wwaltz2/ECE445-UIUC-Heterodyne/README.md

# ECE445-UIUC-Heterodyne
For ease of sharing files, journals, code, and schematics while we design, revise, build, and report on our senior design project.
