wwaltz2/ECE445-UIUC-Heterodyne/Firmware/WAV Files/From Dr OK/For Bill/Big brown bat (Eptesicus fuscus).png

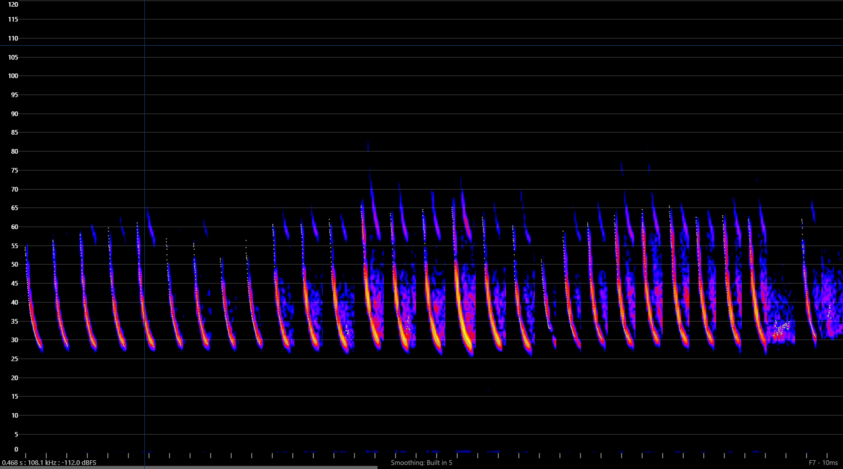
Firmware/WAV Files/From Dr OK/For Bill/Big brown bat (Eptesicus fuscus).png
