wwaltz2/ECE445-UIUC-Heterodyne/Firmware/WAV Files/From Dr OK/For Bill/Eastern red bat (Lasiurus borealis).png

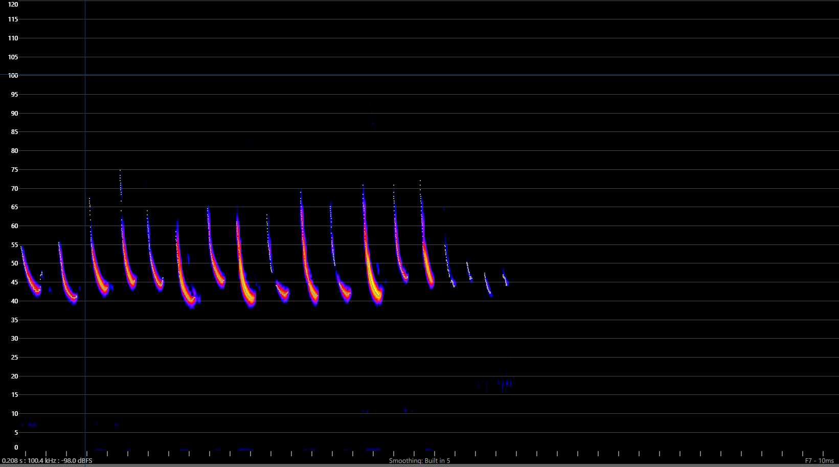
Firmware/WAV Files/From Dr OK/For Bill/Eastern red bat (Lasiurus borealis).png
