wwaltz2/ECE445-UIUC-Heterodyne/Firmware/WAV Files/From Dr OK/For Bill/Indiana bat (Myotis sodalis).png

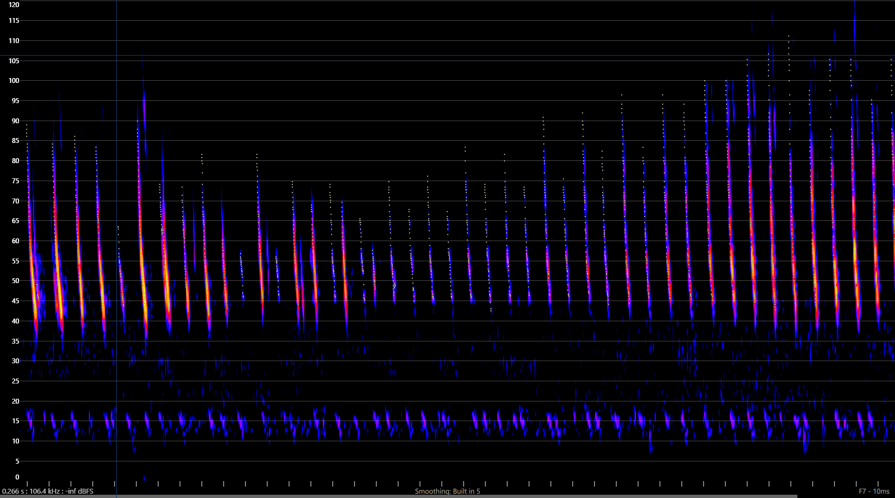
Firmware/WAV Files/From Dr OK/For Bill/Indiana bat (Myotis sodalis).png
