wwaltz2/ECE445-UIUC-Heterodyne/Journals/kaj5/5-6-26_final_chassis.png

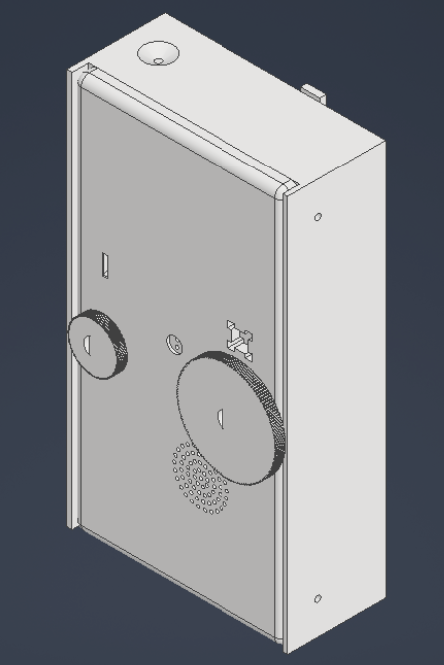
Journals/kaj5/5-6-26_final_chassis.png
