wwaltz2/ECE445-UIUC-Heterodyne/3D Printer Files/Assembly.3mf

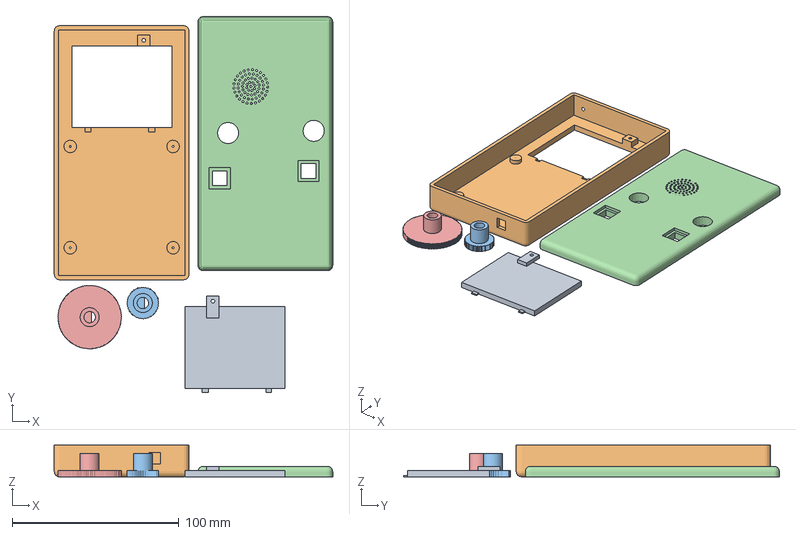
[picture p5: CAD file, 2026-04-19]
3D Printer Files/Assembly.3mf
167.0 x 225.4 x 19.0 mm
batteryFlap.stl
Bottom_Shell.stl
Dial.stl
Top_Shell.stl
freqDial1.stl
