wwaltz2/ECE445-UIUC-Heterodyne/Chassis/3D_print_format/STEP/Top_Shell.stp

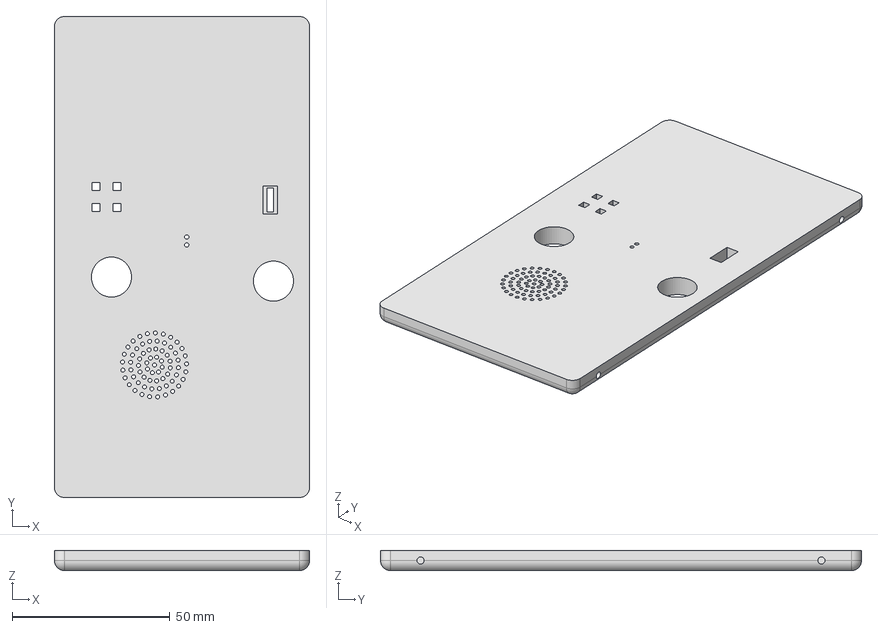
[picture p6: CAD file, 2026-04-22]
Chassis/3D_print_format/STEP/Top_Shell.stp
80.8 x 152.4 x 6.35 mm
