wwaltz2/ECE445-UIUC-Heterodyne/3D Printer Files/batteryFlap.stl

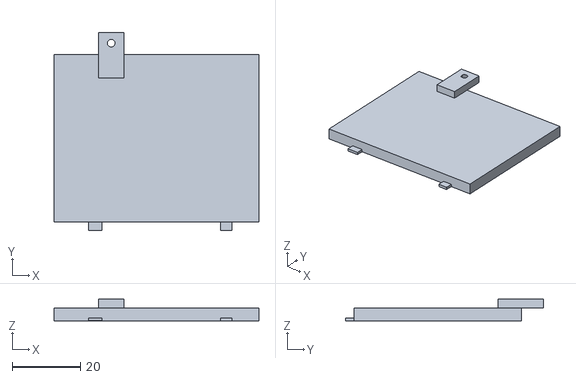
[picture p7: CAD file, 2026-04-19]
3D Printer Files/batteryFlap.stl
59.9 x 58.0 x 6.35
