wwaltz2/ECE445-UIUC-Heterodyne/Chassis/3D_print_format/STEP/Bottom_Shell.stp

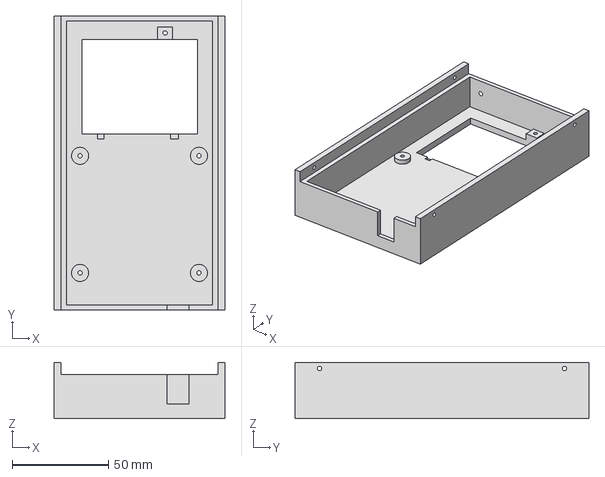
[picture p8: CAD file, 2026-04-20]
Chassis/3D_print_format/STEP/Bottom_Shell.stp
88.5 x 152.4 x 29.2 mm
