wwaltz2/ECE445-UIUC-Heterodyne/Chassis/3D_print_format/team3.3mf

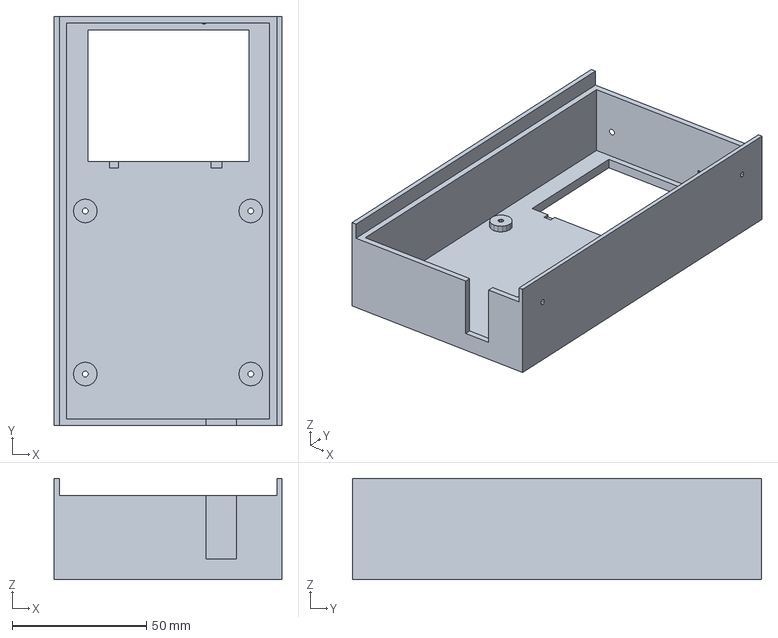
[picture p9: CAD file, 2026-04-27]
Chassis/3D_print_format/team3.3mf
84.9 x 152.4 x 37.7 mm
