wwaltz2/ECE445-UIUC-Heterodyne/3D Printer Files/Top_Shell.stl

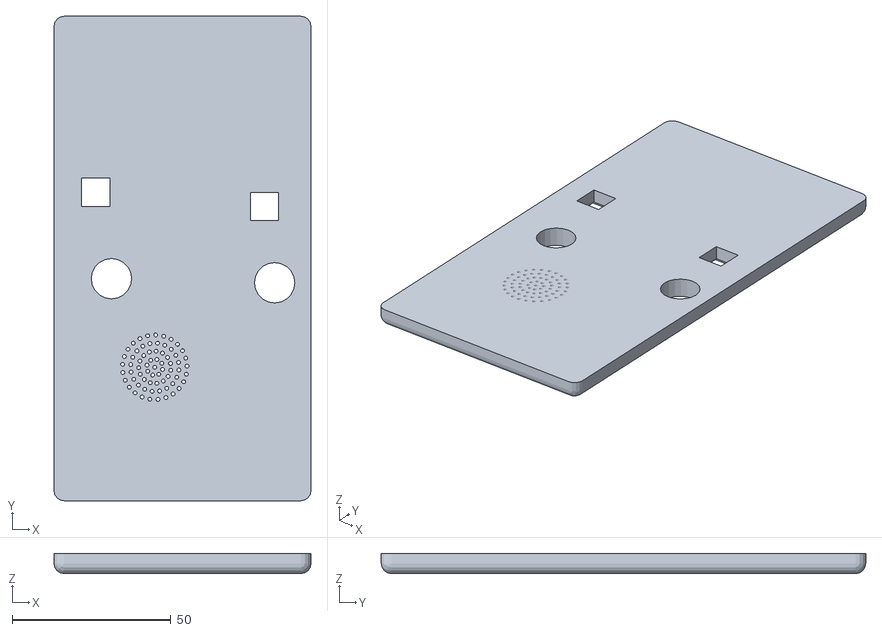
[picture p10: CAD file, 2026-04-19]
3D Printer Files/Top_Shell.stl
80.8 x 152.4 x 6.35
