wwaltz2/ECE445-UIUC-Heterodyne/Chassis/3D_print_format/STEP/Dial.stp

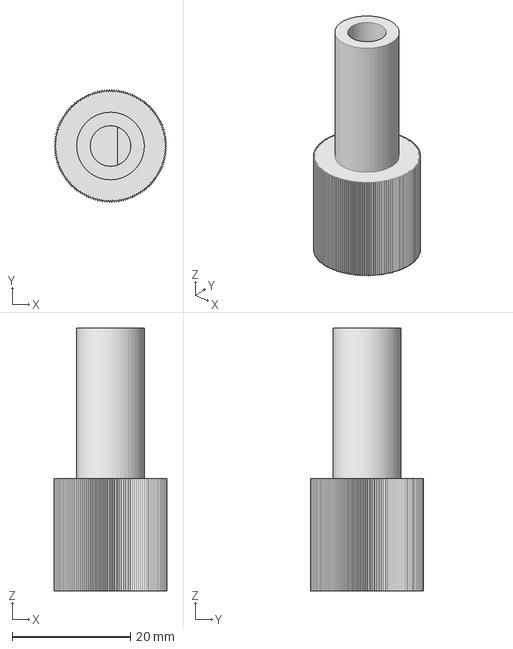
[picture p11: CAD file, 2026-04-09]
Chassis/3D_print_format/STEP/Dial.stp
19.0 x 19.0 x 44.4 mm
