wwaltz2/ECE445-UIUC-Heterodyne/3D Printer Files/freqDial1.stl

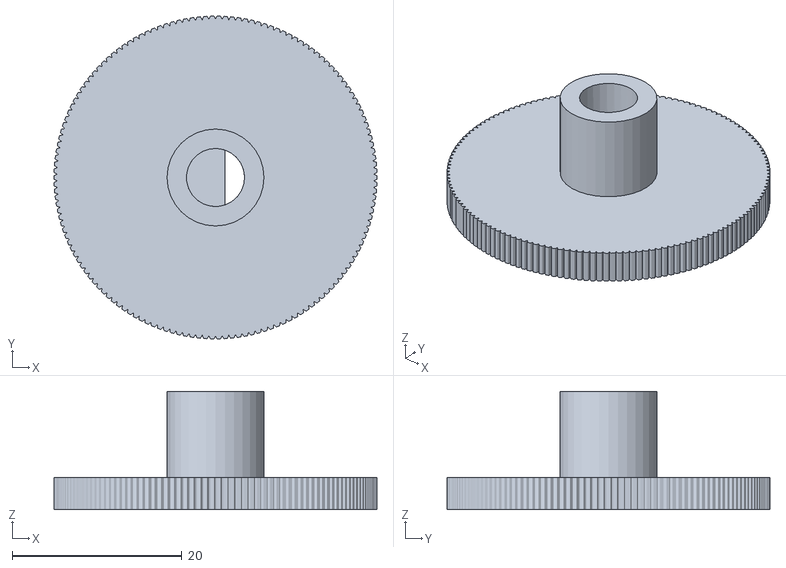
[picture p12: CAD file, 2026-04-19]
3D Printer Files/freqDial1.stl
38.1 x 38.1 x 14.0
