wwaltz2/ECE445-UIUC-Heterodyne/3D Printer Files/Bottom_Shell.stl

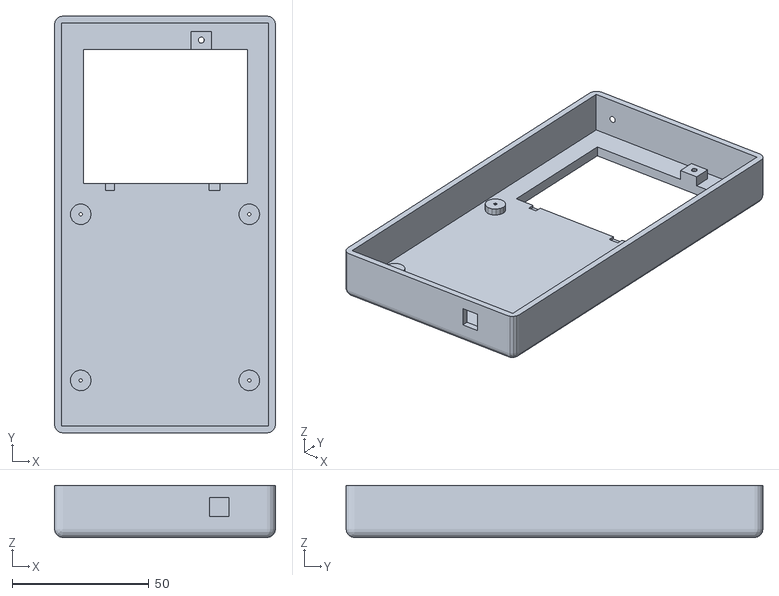
[picture p13: CAD file, 2026-04-19]
3D Printer Files/Bottom_Shell.stl
80.8 x 152.4 x 19.0
