wwaltz2/ECE445-UIUC-Heterodyne/3D Printer Files/Dial.stl

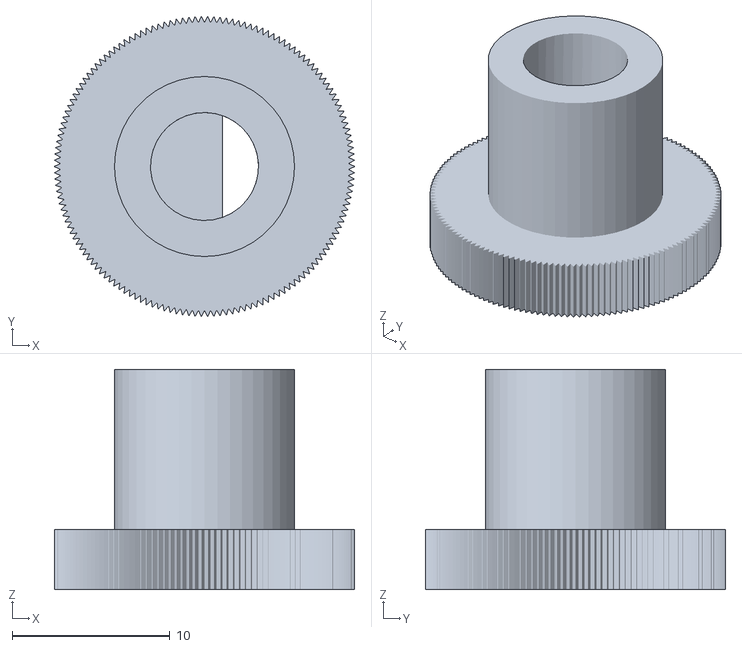
[picture p14: CAD file, 2026-04-19]
3D Printer Files/Dial.stl
19.0 x 19.0 x 14.0
