wwaltz2/ECE445-UIUC-Heterodyne/(list of files, cad)

Other CAD files:
3D Printer Files/group3BatDetector.gcode.3mf
Chassis/3D_print_format/team3_bottom_shell.gcode.3mf
Chassis/3D_print_format/team3.gcode.3mf
3D Printer Files/Assembly.stl
Chassis/3D_print_format/STL/Bottom_Shell.3mf
Chassis/3D_print_format/STL/Bottom_Shell.stl
Chassis/3D_print_format/STL/Dial.stl
Chassis/3D_print_format/STL/Top_Shell.stl
Chassis/Assembly.iam
Chassis/Bottom_Shell.ipt
Chassis/Dial.ipt
Chassis/FreqDial.ipt
Chassis/OldVersions/Assembly.0026.iam
Chassis/OldVersions/Bottom_Shell.0030.ipt
Chassis/OldVersions/Dial.0013.ipt
Chassis/OldVersions/Top_Shell.0032.ipt
Chassis/OldVersions/batteryFlap.0002.ipt
Chassis/Top_Shell.ipt
Chassis/batteryFlap.ipt
Chassis/freqDial1.ipt
