wwaltz2/ECE445-UIUC-Heterodyne/Firmware/WorkingBytewiseAudioloader/extras/Winbond Flash Instructions - Comparison.xlsx

Characteristics | W25X05CL | W25X10BV | W25X20BV | W25X40BV | W25Q80BV | W25Q16BV | W25Q32BV | W25Q64BV | W25Q128BV | W25Q256FV
Size (Bits) | 512K-Bit | 1M-Bit | 2M-Bit | 4M-Bit | 8M-Bit | 16M-Bit | 32M-Bit | 64M-Bit | 128M-Bit | 256M-Bit
Size (Bytes) | 64K-Byte | 128K-Byte | 256K-Byte | 512K-Byte | 1M-Byte | 2M-Byte | 4M-Byte | 8M-Byte | 16M-Byte | 32M-Byte
Programming size | 64L*1024L | 128L*1024L | 256L*1024L | 512L*1024L | 1L*1024L*1024L | 2L*1024L*1024L | 4L*1024L*1024L | 8L*1024L*1024L | 16L*1024L*1024L | 32L*1024L*1024L
No. of pages | 256 | 512 | 1024 | 2048 | 4096 | 8192 | 16384 | 32768 | 65536 | 131072
Voltage | 2.5V - 3.3V | 2.7V - 3.6V | 2.7V - 3.6V | 2.7V - 3.6V | 2.5V - 3.6V | 2.7V to 3.6V | 2.7V to 3.6V | 2.7V to 3.6V | 2.7V to 3.6V | 2.7V to 3.6V
Current (Active) | 1mA | 4mA | 4mA | 4mA | 4mA | 4mA | 4mA | 4mA | 4mA | 4mA
Current (Power-down) | < 1µA | < 1µA | < 1µA | < 1µA | < 1µA | < 1µA | < 1µA | < 1µA | < 1µA | < 1µA
Sector size | 4KB | 4KB | 4KB | 4KB | 4KB | 4KB | 4KB | 4KB | 4KB | 4KB
No. of sectors | 16 | 32 | 64 | 128 | 256 | 512 | 1024 | 2048 | 4096 | 8192
No. of 32K blocks | 2 | 4 | 8 | 16 | 32 | 64 | 128 | 256 | 512 | 1024
No. of 64K blocks | 1 | 2 | 4 | 8 | 16 | 32 | 64 | 128 | 256 | 512
I/O | SPI, DUAL I/O | SPI, Dual Outputs, Dual I/O | SPI, Dual Outputs, Dual I/O | SPI, Dual Outputs, Dual I/O | SPI, Dual SPI, Quad SPI | SPI, Dual SPI, Quad SPI | SPI, Dual SPI, Quad SPI | SPI, Dual SPI, Quad SPI | SPI, Dual SPI, Quad SPI | SPI, Dual SPI, Quad SPI
Max clock speed | 104MHz | 104MHz | 104MHz | 104MHz | 104MHz | 104MHz | 104MHz | 80MHz | 104MHz
Page Program | YES | YES | YES | YES | YES | YES | YES | YES | YES | YES
Identification
Manufacturer ID | EFh | EFh | EFh | EFh | EFh | EFh | EFh | EFh | EFh | EFh
Device ID
Byte 1 (Manufacturer ID) | EFh | EFh | EFh | EFh | EFh | EFh | EFh | EFh | EFh | EFh
Byte 2 (Memory Type) | 05h | 10h | 11h | 12h | 13h | 14h | 15h | 16h | 17h | 18h
Byte 3 (Capacity) | 3010h | 3011h | 3012h | 3013h | 4014h | 4015h | 4016h | 4017h | 4018h | 4019h
Instructions
Write Enable | 06h | 06h | 06h | 06h | 06h | 06h | 06h | 06h | 06h | 06h
Write Enable for Volatile Status Register | 50h | - | - | - | 50h | - | 50h | - | 50h | 50h
Write Disable | 04h | 04h | 04h | 04h | 04h | 04h | 04h | 04h | 04h | 04h
Read Status Register 1 | 05h | 05h | 05h | 05h | 05h | 05h | 05h | 05h | 05h | 05h
Read Status Register 2 | - | - | - | - | 35h | 35h | 35h | 35h | 35h | 35h
Write Status Register 1 | 01h | 01h | 01h | 01h | 01h | 01h | 01h | 01h | 01h | 01h
Write Status Register 2 |  |  |  |  |  |  |  |  |  | 31h
Write Status Register 3 |  |  |  |  |  |  |  |  |  | 11h
Read Extended Addr. Register |  |  |  |  |  |  |  |  |  | C8h
Write Extended Addr. Register |  |  |  |  |  |  |  |  |  | C5h
Read Data | 03h | 03h | 03h | 03h | 03h | 03h | 03h | 03h | 03h | 03h
Fast Read | 0Bh | 0Bh | 0Bh | 0Bh | 0Bh | 0Bh | 0Bh | 0Bh | 0Bh | 0Bh
Fast Read Dual Output | 3Bh | 3Bh | 3Bh | 3Bh | 3Bh | 3Bh | 3Bh | 3Bh | 3Bh | 3Bh
Fast Read Dual I/O | BBh | BBh | BBh | BBh | BBh | BBh | BBh | BBh | BBh | BBh
Fast Read Quad Output | - | - | - | - | 6Bh | 6Bh | 6Bh | 6Bh | 6Bh | 6Bh
Fast Read Quad I/O | - | - | - | - | EBh | EBh | EBh | EBh | EBh | EBh
Word Read Quad I/O | - | - | - | - | E7h | E7h | E7h | - | E7h | E7h
Octal Word Read Quad I/O | - | - | - | - | E3h | E3h | E3h | E3h | E3h | E3h
Set Burst with wrap | - | - | - | - | 77h | - | 77h | - | 77h | 77h
Page Program | 02h | 02h | 02h | 02h | 02h | 02h | 02h | 02h | 02h | 02h
Quad Page Program | - | - | - | - | 32h | 32h | 32h | 32h | 32h | 32h
Sector Erase (4KB) | 20h | 20h | 20h | 20h | 20h | 20h | 20h | 20h | 20h | 20h
Block Erase (32KB) | 52h | 52h | 52h | 52h | 52h | 52h | 52h | 52h | 52h | 52h
Block Erase (64KB) | D8h | D8h | D8h | D8h | D8h | D8h | D8h | D8h | D8h | D8h
Chip Erase | C7h/60h | C7h/60h | C7h/60h | C7h/60h | C7h/60h | C7h/60h | C7h/60h | C7h/60h | C7h/60h | C7h/60h
Erase/Program suspend | - | - | - | - | 75h | 75h | 75h | 75h | 75h | 75h
Erase/Program resume | - | - | - | - | 7Ah | 7Ah | 7Ah | 7Ah | 7Ah | 7Ah
Contiuous Read Mode | - | - | - | - | FFh | FFh | FFh | FFh | FFh | FFh
High Performance Mode | - | - | - | - | - | - | - | A3h | - | -
Power-down | B9h | B9h | B9h | B9h | B9h | B9h | B9h | B9h | B9h | B9h
Release Power-down/ Device ID | ABh | ABh | ABh | ABh | ABh | ABh | ABh | ABh | ABh | ABh
Manufacturer/Device ID | 90h | 90h | 90h | 90h | 90h | 90h | 90h | 90h | 90h | 90h
Manufacturer/Device ID by Dual I/O | 92h | 92h | 92h | 92h | 92h | 92h | 92h | - | 92h | 92h
Manufacturer/Device ID by Quad I/O | - | - | - | - | 94h | 94h | 94h | - | 94h | 94h
JEDEC ID | 9Fh | 9Fh | 9Fh | 9Fh | 9Fh | 9Fh | 9Fh | 9Fh | 9Fh | 9Fh
Read Unique ID | 4Bh | 4Bh | 4Bh | 4Bh | 4Bh | 4Bh | 4Bh | 4Bh | 4Bh | 4Bh
Read SDFP Register | - | - | - | - | 5Ah | - | 5Ah | - | 5Ah
Erase Security Registers | - | - | - | - | 44h | - | 44h | - | 44h
Program Security Registers | - | - | - | - | 42h | - | 42h | - | 42h
Read Security Registers | - | - | - | - | 48h | - | 48h | - | 48h
Global Block Lock |  |  |  |  |  |  |  |  |  | 7Eh
Global Block Unlock |  |  |  |  |  |  |  |  |  | 98h
Individual Block Lock |  |  |  |  |  |  |  |  |  | 36h
Individual Block Unlock |  |  |  |  |  |  |  |  |  | 39h
Read Block Lock |  |  |  |  |  |  |  |  |  | 3Dh
