wwaltz2/ECE445-UIUC-Heterodyne/Journals/kaj5/4-9-26_Chassis_Assembly_V2_5.png

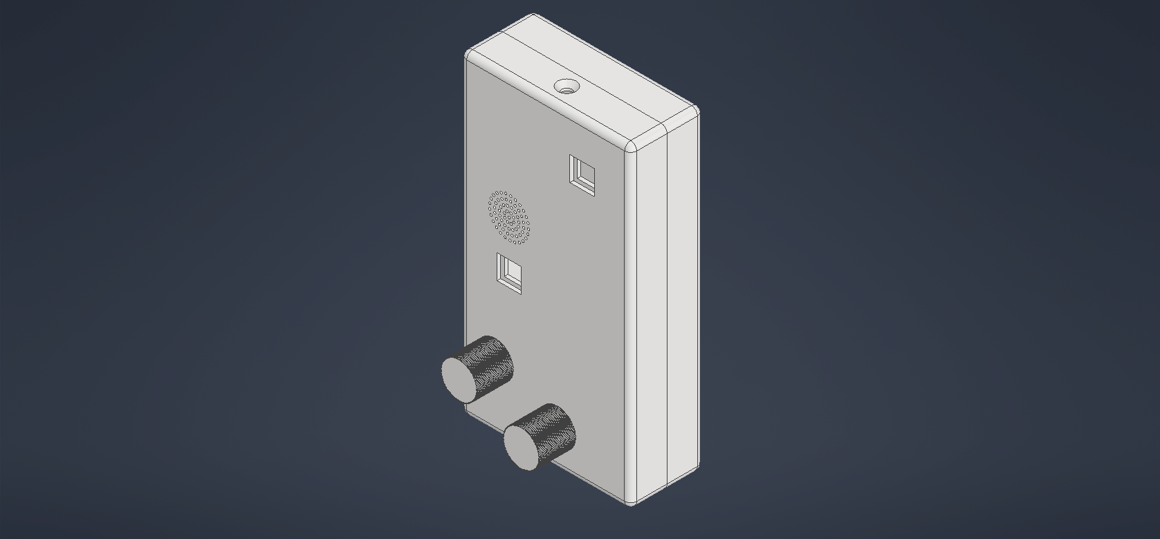
Journals/kaj5/4-9-26_Chassis_Assembly_V2_5.png
