wwaltz2/ECE445-UIUC-Heterodyne/Journals/kaj5/4-16-26-Printed_Chassis_2_5_w_PCB.jpg

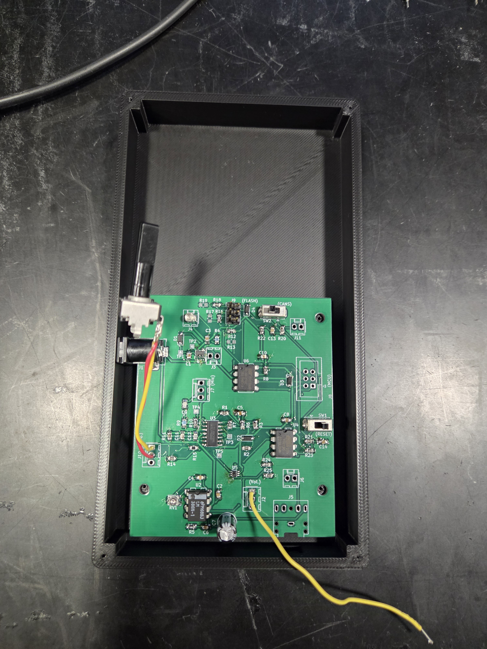
Journals/kaj5/4-16-26-Printed_Chassis_2_5_w_PCB.jpg
