wwaltz2/ECE445-UIUC-Heterodyne/Journals/meeting-notes.md

### Date : 2-24-2026  
- Schematic complete for first round.
- Analog mixing - no digital sampling.
- No machine shop requirements - 3D printing the box.

### Design review comments  
- Change high-level requirement no.3 : Mention the bat sound playback capability
- Define the input signal : Plot the frequency spectrum of a typical bat call and the typical decibels that reach a listener.

### Breadboard demo  
- Displayed oscillator output - range is 14kHz to 110 kHz.  
- Used bench top power supply with on board regulator.
- Submitted one board in round 1 and two boards in round 2 (mic separate) + stencils
