wwaltz2/ECE445-UIUC-Heterodyne/Journals/evandm2/evandm2 Engineering Log 5-3-26.md

## ECE445 Engineering Log #26

May 3, 2026\
Evan McGowan

Pretty much done! We had our demo on Wednesday, and I feel like it went pretty well. Hopefully at least a 120/150. We were able to demo everything we needed to, though the range and volume on the device are disastrous. A more powerful amplifier, better microphone, and higher-quality speaker are certainly in the cards for future iterations. A better mixer would be helpful, but it isn't strictly necessary. The project would have been so much easier with an off-the-shelf mixer+oscillator IC, but that's the fun of senior design, isn't it?

The final presentation was on Friday morning, and that also went pretty well. The only feedback we received was to include the data points in the graph I made for the oscillator frequency vs. resistance, so I fixed that for the final report. Speaking of the final report, I've pretty much done all I need to for it. The work I did for the IPR and previous revisions to the RV table made up the majority of the work I had to do, so I was able to get my part done within a couple of hours. The rest can be done by Bill and Kyle. Very happy to be done with the project. I'll check over everything, especially with the future work section, but I'm basically done with undergrad! Crazy. I hope someone picks it up next semester and finds my logs useful. I rambled quite a bit.

This is (likely to be) my final log for ECE445, covering the Heterodyne Bat Detector project. I may or may not get around to making the changes on the schematic described in the past few logs (R+C on mixer output, removing two resistors on CANS line, etc.), we shall see.
