wwaltz2/ECE445-UIUC-Heterodyne/Journals/evandm2/evandm2 Engineering Log 3-30-26.md

## ECE445 Engineering Log #19

March 30, 2026\
Evan McGowan

Catch-up from last week:

Soldered one of the microphone boards using the stencil, kind of annoying with the soldering equipment that's in the lab, but whatever. Tested it on our breadboard and thankfully it works as expected! I set the oscillator to 40kHz and used the CAL setting on Dr. O'Keefe's ultrasound calibrator (centers at 40kHz), and was able to hear a low-frequency tone, indicating that our oscillator, microphone, microphone amplifier, mixer, AND audio amplifier all work as expected!!!! Very big success here, really happy with this.

Updated the bill of materials to include extra resistors that Bill needed for the digital part, and sent PCB rev 4 to Gayatri. I have no reason to believe that we'll need another design after this, only things may be adding bodge wires, but I doubt that's necessary.

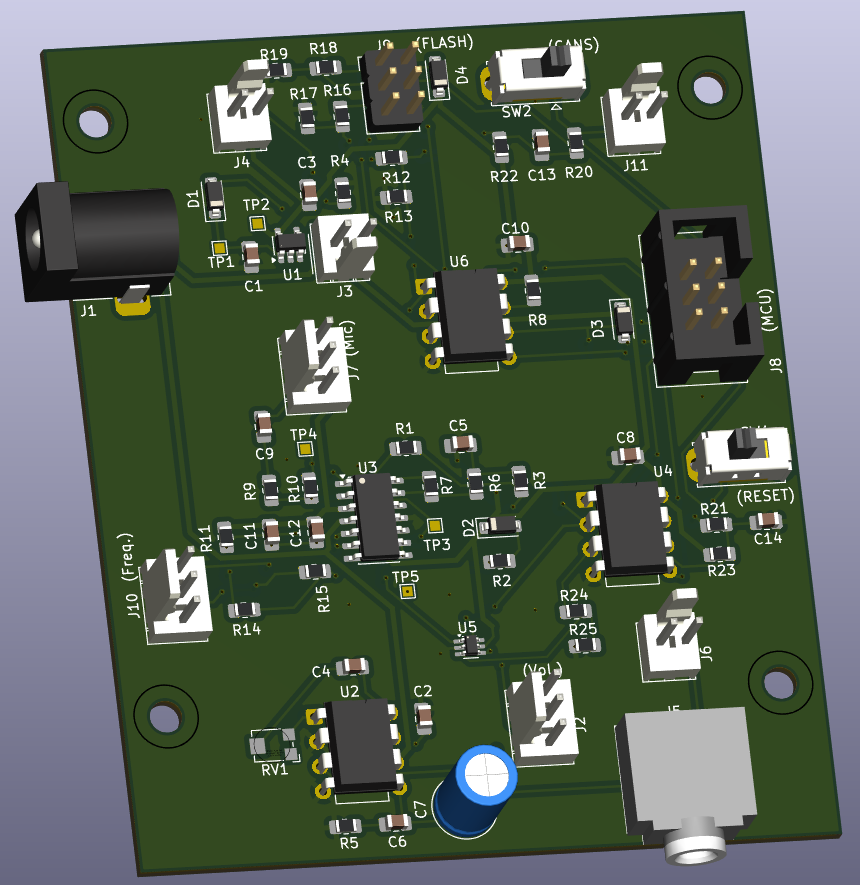
[picture p19: Journals/evandm2/pcb_round4.png]
The round 4 PCB.


I also started working on the progress report last week, and came in today to grab oscilloscope traces to put in the report. Everything on my end is going very well. I'm leaving the soldering work for PCB v2 up to Bill/Kyle, and I may do some for the final iteration, but I don't feel like doing that with all the work I've done so far. I know they can handle it.

Soldered the remaining 4 microphones onto our breakout boards. Only 3/5 are working right now, but I think this will be more than enough for the rest of our project as long as nothing gets blown up.

Assorted pictures that I grabbed earlier today:

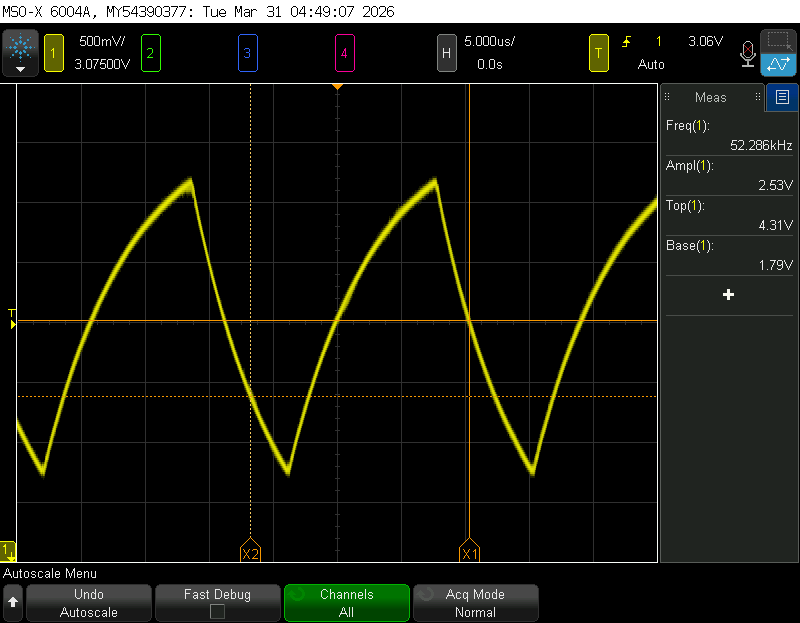
[picture p20: Journals/evandm2/breadboard_oscillator.png]
Breadboard oscillator response for R = 248 ohms.

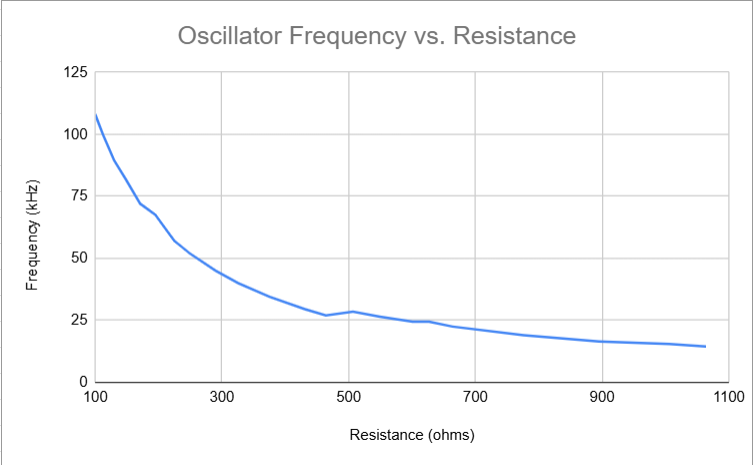
[picture p21: Journals/evandm2/f_vs_r.png]
Frequency vs resistance data grabbed from multimeter + scope traces.

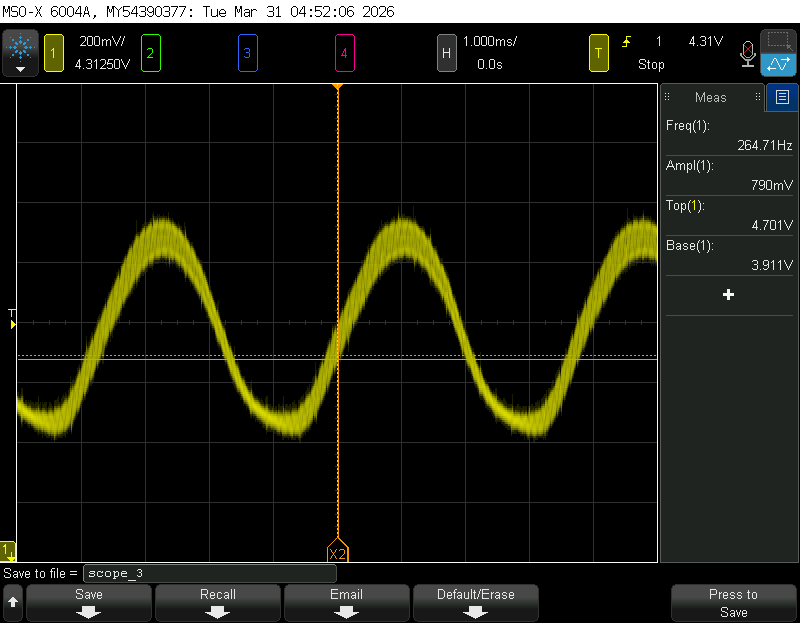
[picture p22: Journals/evandm2/breadboard_mixer.png]
Mixer operating with 52.3kHz and 52kHz input signals.

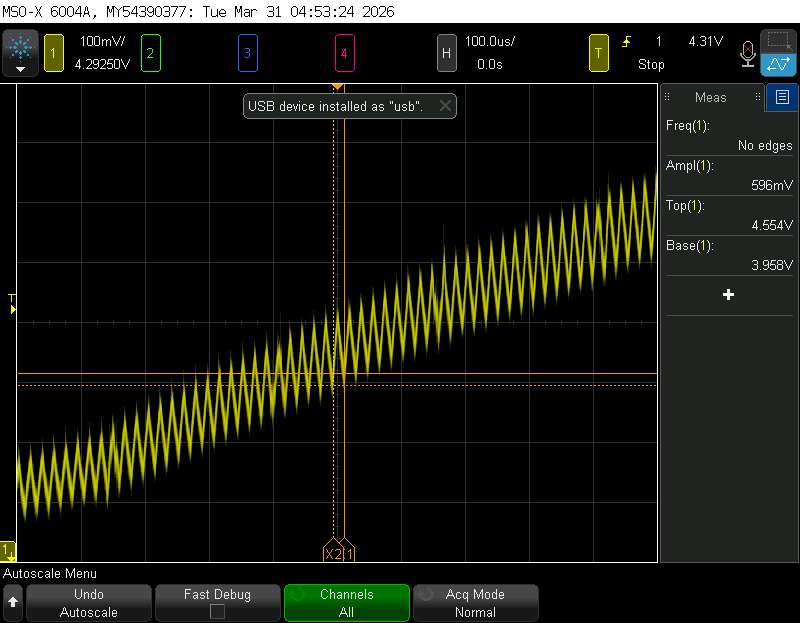
[picture p23: Journals/evandm2/mixer_ripple.png]
High-frequency voltage ripple seen on our mixer output due to poor input isolation.


Alt text contains more info on each picture.
