wwaltz2/ECE445-UIUC-Heterodyne/Journals/evandm2/evandm2 Engineering Log 2-26-26.md

## ECE445 Engineering Log #13

February 26, 2026\
Evan McGowan

Retroactively adding this journal entry because I forgot to write it the day of.

Finished up the bill of materials to make sure that we had properly-sized components for everything. DigiKey and E-Shop orders were sent in, so we should receive the materials by the time we get our PCB.

Yesterday, Bill finished up the PCB, and I checked the routing & such. It looks good, sent it off that night to Gayatri after passing audit on PCBWay...not JLCPCB. I switched the two of them in my head, but the tolerances should be alright. We may want to create a tiny daughterboard for the microphone that plugs into the main board, as controlling where the microphone is placed is done in the Bat4, which we'd like to replicate.
