wwaltz2/ECE445-UIUC-Heterodyne/Journals/kaj5/Program_Flowchart.png

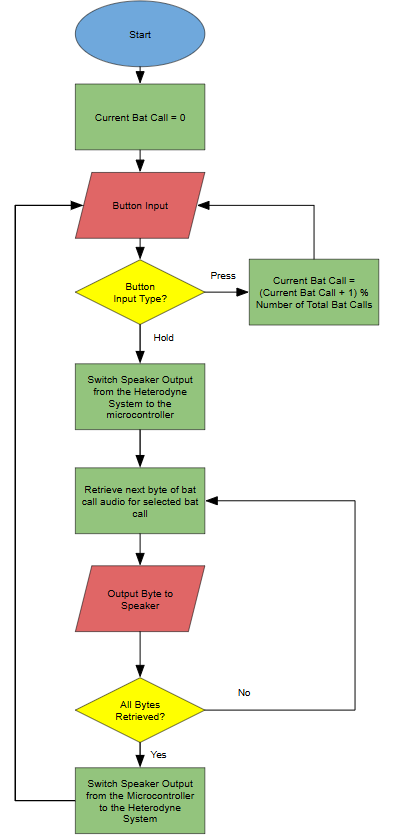
Journals/kaj5/Program_Flowchart.png
