wwaltz2/ECE445-UIUC-Heterodyne/LTspice Simulations/MixerOscillator.asc

C1: cap; 4.7n
C2: cap; 22n
C3: cap; 4.7n
D1: diode; BAT54
R1: res; 1k
R2: res; 1k
R3: res; 100k
R4: res; 3.3k
R5: res; 1k
R6: res; 100
R7: res; 1k
R8: res; 1k
R9: res; 100
R10: res; 50
U1: opamp2; TLV9052
U2: opamp2; TLV9052
U3: opamp2; TLV9052
V1: voltage; 6
V2: voltage; 3.3
V3: voltage; SINE(0 0.1 64.3k)
Named nets: V+, 0, 3v3, out
.tran 0 6m 2m
.lib tlv9052.lib
