wwaltz2/ECE445-UIUC-Heterodyne/LTspice Simulations/Oscillator.asc

C1: cap; 22n
C3: cap; 4.7n
R1: res; {R1}
R2: res; 1k
R3: res; 1k
R4: res; 100
U1: opamp2; TLV9052
U2: opamp2; TLV9052
V1: voltage; 6
V2: voltage; 3.3
Named nets: V+, 0, 3v3, out
.lib tlv9052.lib
.tran 0 1.2m 0.2m
.step param R1 list 10 100 1k
