wwaltz2/ECE445-UIUC-Heterodyne/LTspice Simulations/Mixer.asc

C1: cap; 1µ
D1: diode; BAT54
R1: res; 1k
R2: res; 1k
R3: res; 1k
R4: res; 10k
R5: res; 470
U1: opamp2; TLV9052
V1: voltage; 6
V2: voltage; 3.3
V3: voltage; SINE(0 5 60k)
V4: voltage; SINE(0 5 61k)
Named nets: V+, 0, out, 3v3
.tran 0 6m 2m
.lib tlv9052.lib
