wwaltz2/ECE445-UIUC-Heterodyne/Heterodyne_Board/Heterodyne_Board.kicad_pcb

## KiCad design Heterodyne_Board/Heterodyne_Board.kicad_pcb (2026-03-26)

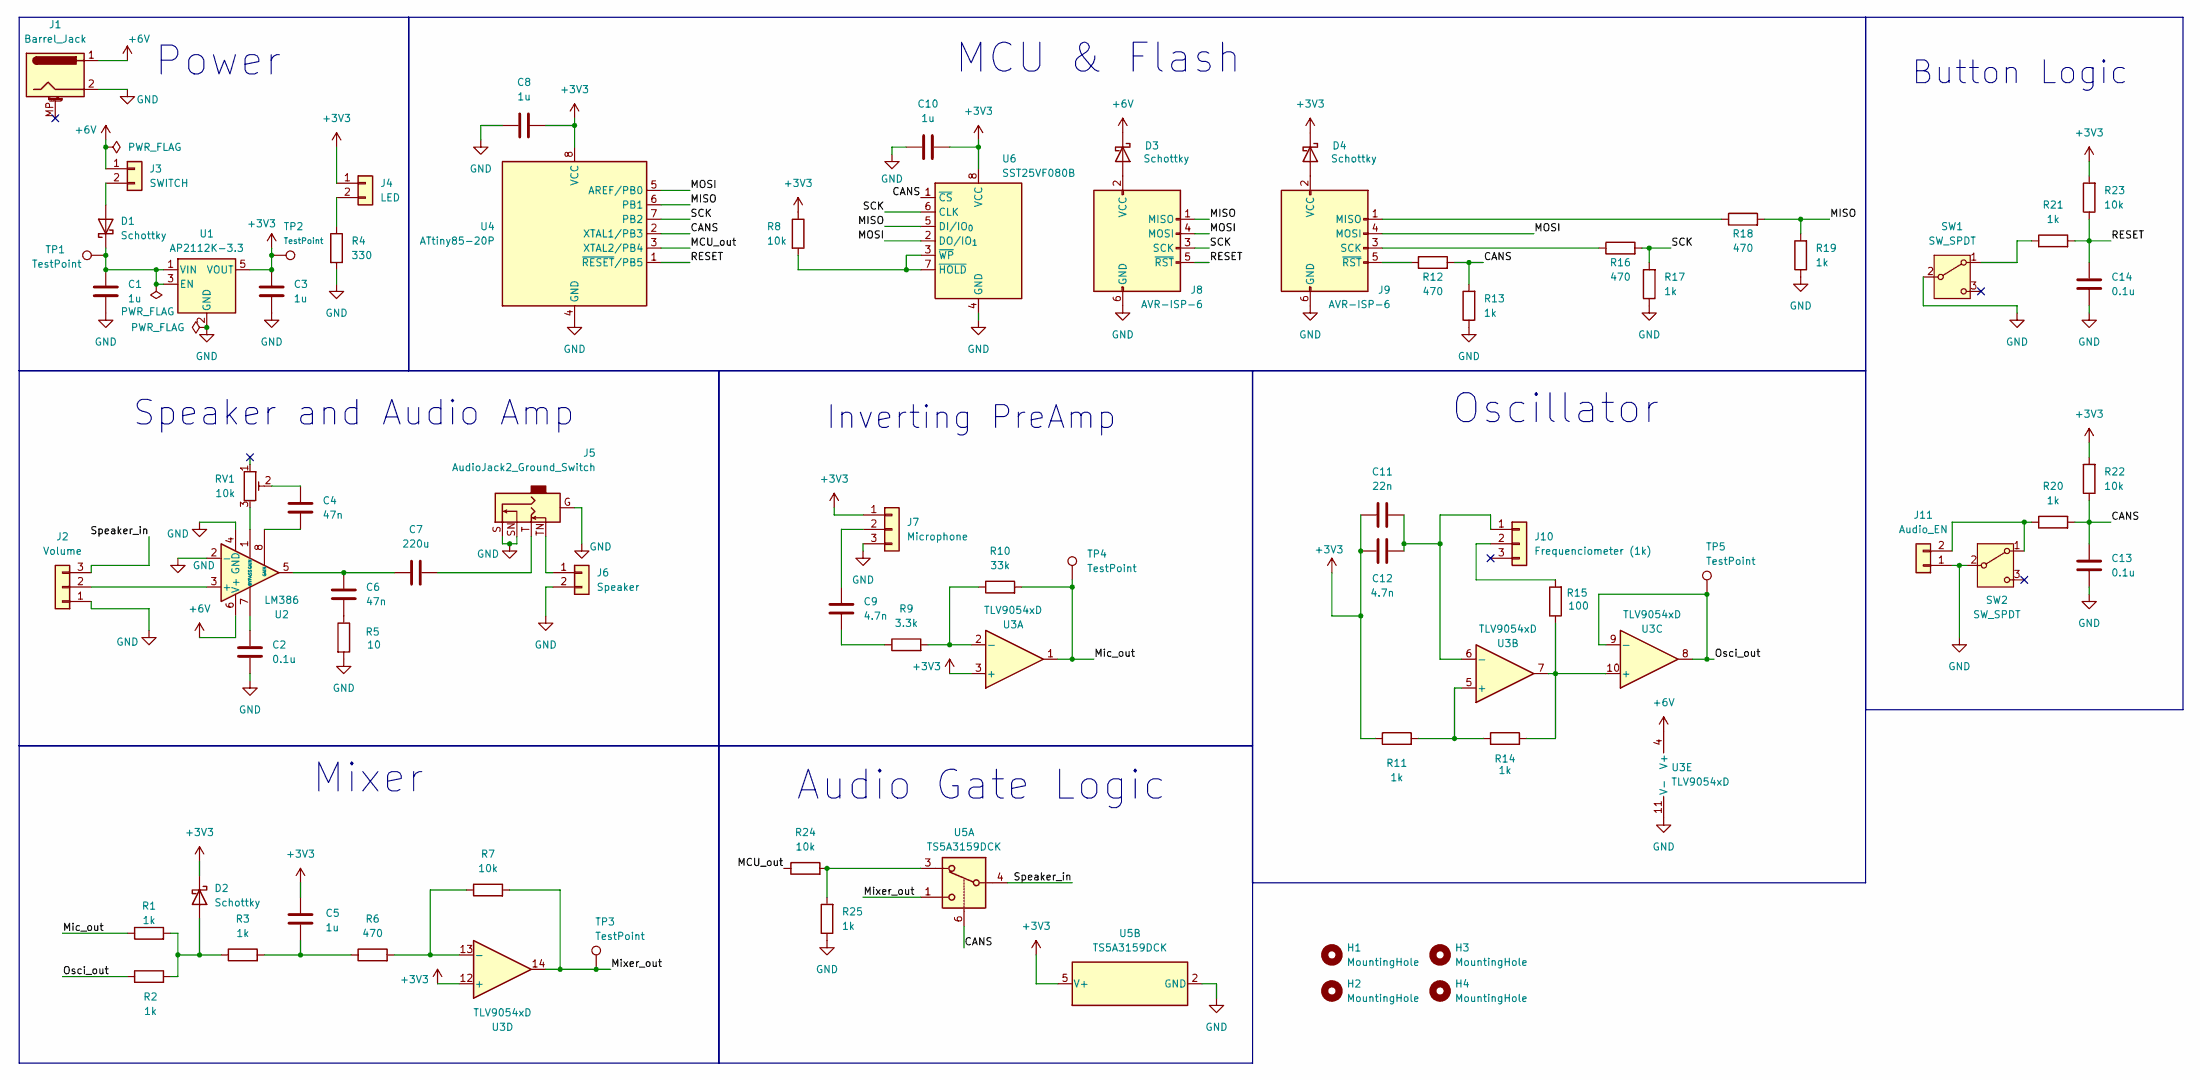
[picture p30: schematic Heterodyne_Board.kicad_sch]

Parts:
C1, C3, C5, C8, C10: 1u; C_0805_2012Metric_Pad1.18x1.45mm_HandSolder
C2, C13, C14: 0.1u; C_0805_2012Metric_Pad1.18x1.45mm_HandSolder
C4, C6: 47n; C_0805_2012Metric_Pad1.18x1.45mm_HandSolder
C7: 220u; C_Radial_D6.3mm_H11.0mm_P2.50mm
C9, C12: 4.7n; C_0805_2012Metric_Pad1.18x1.45mm_HandSolder
C11: 22n; C_0805_2012Metric_Pad1.18x1.45mm_HandSolder
D1, D2, D3, D4: Schottky; D_SOD-123
H1, H2, H3, H4: MountingHole; MountingHole_3.2mm_M3
J1: Barrel_Jack; BarrelJack_Horizontal
J2: Volume; Molex_KK-254_AE-6410-03A_1x03_P2.54mm_Vertical
J3: SWITCH; Molex_KK-254_AE-6410-02A_1x02_P2.54mm_Vertical
J4: LED; Molex_KK-254_AE-6410-02A_1x02_P2.54mm_Vertical
J5: AudioJack2_Ground_Switch; Jack_3.5mm_CUI_SJ1-3525N_Horizontal
J6: Speaker; Molex_KK-254_AE-6410-02A_1x02_P2.54mm_Vertical
J7: Microphone; Molex_KK-254_AE-6410-03A_1x03_P2.54mm_Vertical
J8: AVR-ISP-6; IDC-Header_2x03_P2.54mm_Vertical
J9: AVR-ISP-6; PinHeader_2x03_P2.54mm_Vertical
J10: Frequenciometer (1k); Molex_KK-254_AE-6410-03A_1x03_P2.54mm_Vertical
J11: Audio_EN; Molex_KK-254_AE-6410-02A_1x02_P2.54mm_Vertical
R1, R2, R3, R11, R13, R14, R17, R19, R20, R21, R25: 1k; R_0805_2012Metric_Pad1.20x1.40mm_HandSolder
R4: 330; R_0805_2012Metric_Pad1.20x1.40mm_HandSolder
R5: 10; R_0805_2012Metric_Pad1.20x1.40mm_HandSolder
R6, R12, R16, R18: 470; R_0805_2012Metric_Pad1.20x1.40mm_HandSolder
R7, R8, R22, R23, R24: 10k; R_0805_2012Metric_Pad1.20x1.40mm_HandSolder
R9: 3.3k; R_0805_2012Metric_Pad1.20x1.40mm_HandSolder
R10: 33k; R_0805_2012Metric_Pad1.20x1.40mm_HandSolder
R15: 100; R_0805_2012Metric_Pad1.20x1.40mm_HandSolder
RV1: 10k; Potentiometer_Bourns_TC33X_Vertical
SW1, SW2: SW_SPDT; SW_Slide_SPDT_Straight_CK_OS102011MS2Q
TP1, TP2, TP3, TP4, TP5: TestPoint; TestPoint_Pad_1.0x1.0mm
U1: AP2112K-3.3; SOT-23-5
U2: LM386; DIP-8_W7.62mm
U3: TLV9054xD; SOIC-14_3.9x8.7mm_P1.27mm
U4: ATtiny85-20P; DIP-8_W7.62mm
U5: TS5A3159DCK; SOT-363_SC-70-6
U6: SST25VF080B; DIP-8_W7.62mm

Connections:
+3V3: C3.1, C5.1, C8.2, C10.2, C11.1, C12.1, D2.1 (K), D4.1 (K), J4.1, J7.1, R8.1, R11.1, R22.2, R23.2, TP2.1, U1.5 (VOUT), U3.3 (+), U3.12 (+), U4.8 (VCC), U5.5 (V+), U6.8 (VCC)
+6V: D3.1 (K), J1.1, J3.1, U2.6 (V+), U3.4 (V+)
/CANS: C13.2, R12.2, R13.2, R20.2, R22.1, U4.2 (XTAL1/PB3), U5.6, U6.1 (~CS)
/MCU_out: R24.1, U4.3 (XTAL2/PB4)
/MISO: J8.1 (MISO), R18.2, R19.2, U4.6 (PB1), U6.5 (DI/IO_{0})
/MOSI: J8.4 (MOSI), J9.4 (MOSI), U4.5 (AREF/PB0), U6.2 (DO/IO_{1})
/Mic_out: R1.1, R10.2, TP4.1, U3.1
/Mixer_out: R7.2, TP3.1, U3.14, U5.1
/Osci_out: R2.1, TP5.1, U3.8, U3.9 (-)
/RESET: C14.2, J8.5 (~RST), R21.2, R23.1, U4.1 (~RESET/PB5)
/SCK: J8.3 (SCK), R16.2, R17.2, U4.7 (PB2), U6.6 (CLK)
/Speaker_in: J2.3, U5.4
GND: C1.2, C2.1, C3.2, C8.1, C10.1, C13.1, C14.1, J1.2, J2.1, J5.G, J5.S, J5.SN, J6.2, J7.3, J8.6 (GND), J9.6 (GND), J11.1, R4.2, R5.2, R13.1, R17.1, R19.1, R25.1, SW1.2 (B), SW2.2 (B), U1.2 (GND), U2.2 (-), U2.4 (GND), U3.11 (V-), U4.4 (GND), U5.2 (GND), U6.4 (GND)
unnamed: C4.1, U2.8 (GAIN)
unnamed: C4.2, RV1.2
unnamed: C5.2, R3.2, R6.1
unnamed: C6.1, R5.1
unnamed: C6.2, C7.1, U2.5
unnamed: C7.2, J5.T
unnamed: C9.2, R9.1
unnamed: D1.2 (A), J3.2
unnamed: C1.1, D1.1 (K), TP1.1, U1.1 (VIN), U1.3 (EN)
unnamed: D2.2 (A), R1.2, R2.2, R3.1
unnamed: D3.2 (A), J8.2 (VCC)
unnamed: D4.2 (A), J9.2 (VCC)
unnamed: J2.2, U2.3 (+)
unnamed: J4.2, R4.1
unnamed: J5.TN, J6.1
unnamed: C9.1, J7.2
unnamed: J9.1 (MISO), R18.1
unnamed: J9.3 (SCK), R16.1
unnamed: J9.5 (~RST), R12.1
unnamed: C11.2, C12.2, J10.1, U3.6 (-)
unnamed: J10.2, R15.2
unnamed: J11.2, R20.1, SW2.1 (A)
unnamed: R24.2, R25.2, U5.3
unnamed: RV1.3, U2.1 (GAIN)
unnamed: R21.1, SW1.1 (A)
unnamed: C2.2, U2.7 (BYPASS)
unnamed: R9.2, R10.1, U3.2 (-)
unnamed: R11.2, R14.1, U3.5 (+)
unnamed: R14.2, R15.1, U3.7, U3.10 (+)
unnamed: R6.2, R7.1, U3.13 (-)
unnamed: R8.2, U6.3 (~WP), U6.7 (~HOLD)

Notes on the sheet:
MCU & Flash
Inverting PreAmp
Speaker and Audio Amp
Oscillator
Power
Mixer
Button Logic
Audio Gate Logic

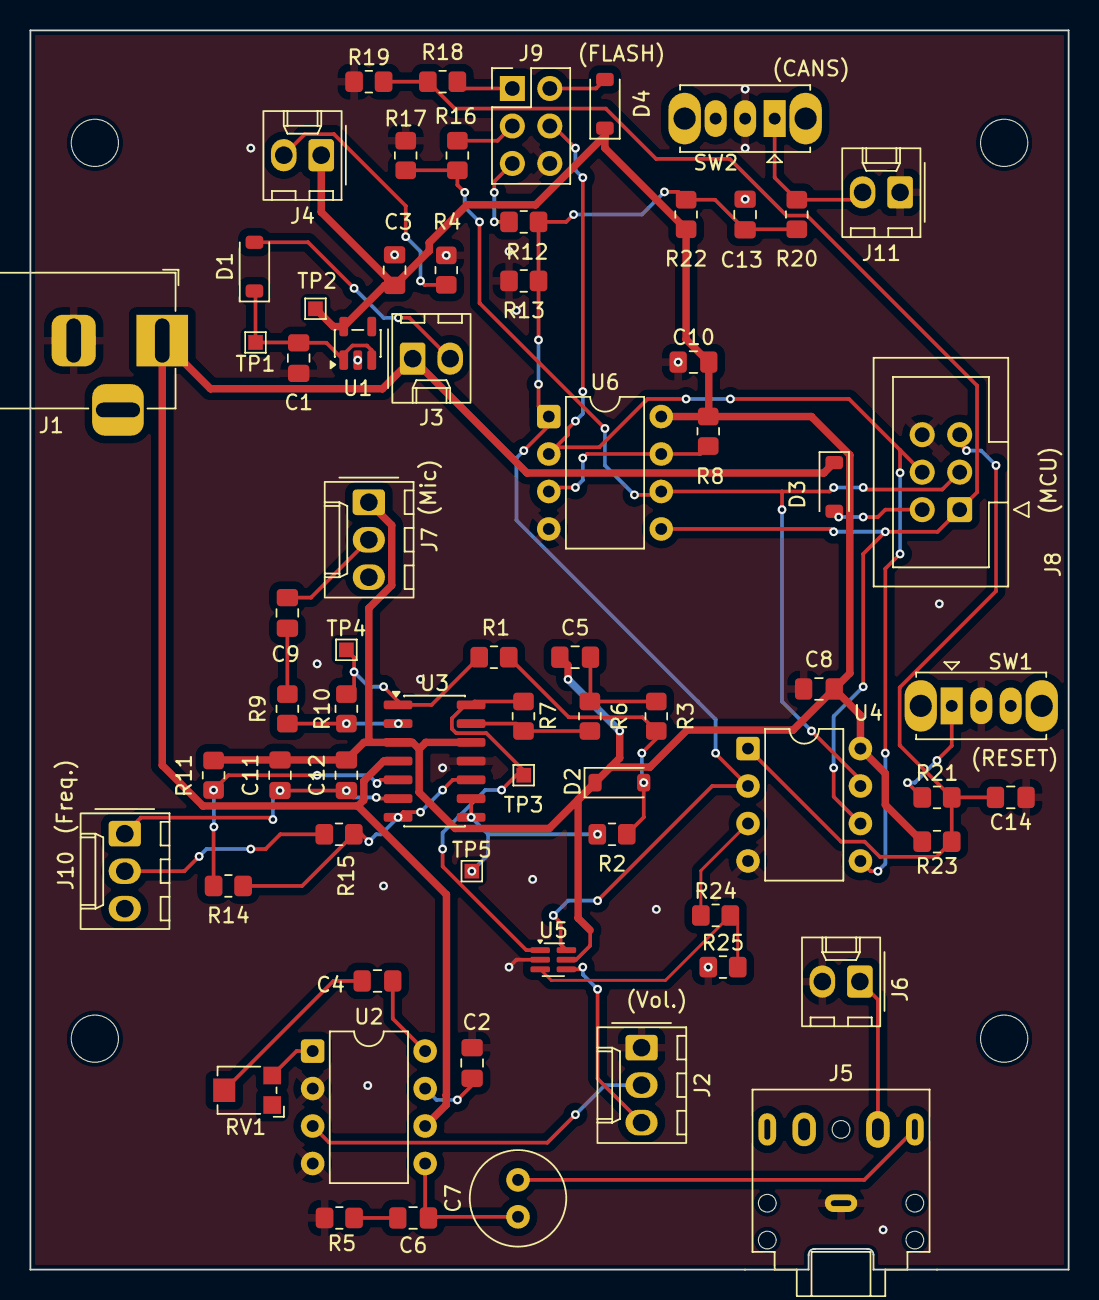
[picture p31: board Heterodyne_Board.kicad_pcb from above]

Board: 2 copper layers, 70.4 x 84.0 mm, 72 parts (0 on the bottom side), 44 nets.
