wwaltz2/ECE445-UIUC-Heterodyne/Heterodyne_Board/Heterodyne_subBoard_Mic/Heterodyne_subBoard_Mic.kicad_pcb

## KiCad design Heterodyne_Board/Heterodyne_subBoard_Mic/Heterodyne_subBoard_Mic.kicad_pcb (2026-03-04)

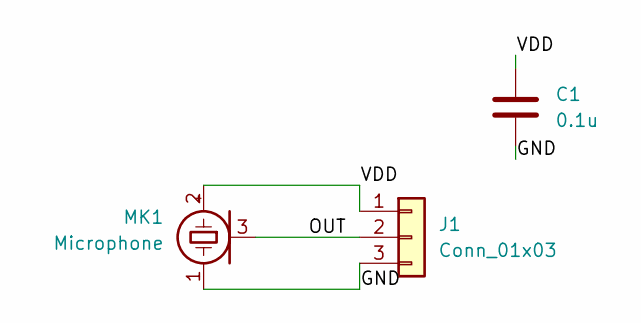
[picture p32: schematic Heterodyne_subBoard_Mic.kicad_sch]

Parts:
C1: 0.1u; C_0805_2012Metric_Pad1.18x1.45mm_HandSolder
J1: Conn_01x03; PinHeader_1x03_P2.54mm_Vertical
MK1: Microphone; 445_MEMS-5_3.5x2.65mm

Connections:
/GND: C1.2, J1.3, MK1.1 (-)
/OUT: J1.2, MK1.3 (+)
/VDD: C1.1, J1.1, MK1.2 (+)

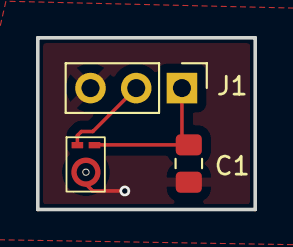
[picture p33: board Heterodyne_subBoard_Mic.kicad_pcb from above]

Board: 2 copper layers, 12.1 x 9.5 mm, 3 parts (0 on the bottom side), 3 nets.
