wwaltz2/ECE445-UIUC-Heterodyne/Firmware/WorkingBytewiseAudioloader/src/SPIMemory.h

/* Arduino SPIMemory Library v.3.4.0
 * Copyright (C) 2017 by Prajwal Bhattaram
 * Created by Prajwal Bhattaram - 18/04/2018
 * Modified by Prajwal Bhattaram - 03/06/2019
 *
 * This file is part of the Arduino SPIMemory Library. This library is for
 * Flash and FRAM memory modules. In its current form it enables reading,
 * writing and erasing data from and to various locations;
 * suspending and resuming programming/erase and powering down for low power operation.
 *
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
 * You should have received a copy of the GNU General Public License v3.0
 * along with the Arduino SPIMemory Library.  If not, see
 * <http://www.gnu.org/licenses/>.
 */

#ifndef SPIMEMORY_H
#define SPIMEMORY_H
//~~~~~~~~~~~~~~~~~~~~~~~~~~~~~~~~~~~~~~~~~~~~~~~~~~~~~~~~~~~~~~~~~~~~//
//    Uncomment the code below to enable SFDP discovery - especially  //
//                    if using an unsupported chip                    //
//                                                                    //
//~~~~~~~~~~~~~~~~~~~~~~~~~~~~~~~~~~~~~~~~~~~~~~~~~~~~~~~~~~~~~~~~~~~~//
#define USES_SFDP                                                   //
//~~~~~~~~~~~~~~~~~~~~~~~~~~~~~~~~~~~~~~~~~~~~~~~~~~~~~~~~~~~~~~~~~~~~//

//~~~~~~~~~~~~~~~~~~~~~~~~~~~~~~~~~~~~~~~~~~~~~~~~~~~~~~~~~~~~~~~~~~~~//
//     Uncomment the code below to run a diagnostic if your flash 	  //
//                         does not respond                           //
//                                                                    //
//      Error codes will be generated and returned on functions       //
//~~~~~~~~~~~~~~~~~~~~~~~~~~~~~~~~~~~~~~~~~~~~~~~~~~~~~~~~~~~~~~~~~~~~//
#define RUNDIAGNOSTIC                                               //
//~~~~~~~~~~~~~~~~~~~~~~~~~~~~~~~~~~~~~~~~~~~~~~~~~~~~~~~~~~~~~~~~~~~~//

//~~~~~~~~~~~~~~~~~~~~~~~~~~~~~~~~~~~~~~~~~~~~~~~~~~~~~~~~~~~~~~~~~~~~//
//   Uncomment the code below to increase the speed of the library    //
//                  by disabling _notPrevWritten()                    //
//                                                                    //
// Make sure the sectors being written to have been erased beforehand //
//~~~~~~~~~~~~~~~~~~~~~~~~~~~~~~~~~~~~~~~~~~~~~~~~~~~~~~~~~~~~~~~~~~~~//
//#define HIGHSPEED                                                   //
//~~~~~~~~~~~~~~~~~~~~~~~~~~~~~~~~~~~~~~~~~~~~~~~~~~~~~~~~~~~~~~~~~~~~//

//~~~~~~~~~~~~~~~~~~~~~~~~~~~~~~~~~~~~~~~~~~~~~~~~~~~~~~~~~~~~~~~~~~~~//
//   Uncomment the code below to disable overflow and force data      //
//   to only be written to the last address of the flash memory       //
//    and not rollover to address 0x00 when the end is reached        //
//~~~~~~~~~~~~~~~~~~~~~~~~~~~~~~~~~~~~~~~~~~~~~~~~~~~~~~~~~~~~~~~~~~~~//
//#define DISABLEOVERFLOW                                             //
//~~~~~~~~~~~~~~~~~~~~~~~~~~~~~~~~~~~~~~~~~~~~~~~~~~~~~~~~~~~~~~~~~~~~//

//~~~~~~~~~~~~~~~~~~~~~~~~~~~~~~~~~~~~~~~~~~~~~~~~~~~~~~~~~~~~~~~~~~~~//
//   Comment out the code below to disable DMA mode on SAMD based     //
//                        platforms (In ALPHA)                        //
//                                                                    //
//   Change the ZERO_SPISERCOM define below to use other SPI ports    //
//~~~~~~~~~~~~~~~~~~~~~~~~~~~~~~~~~~~~~~~~~~~~~~~~~~~~~~~~~~~~~~~~~~~~//
//#define ENABLEZERODMA                                               //
//#define ZERO_SPISERCOM SERCOM4                                      //
//~~~~~~~~~~~~~~~~~~~~~~~~~~~~~~~~~~~~~~~~~~~~~~~~~~~~~~~~~~~~~~~~~~~~//

  #include <Arduino.h>
  #include <SPI.h>
  #include "defines.h"
  #include "SPIFlash.h"
  #include "SPIFram.h"
  #include "diagnostics.h"

#if defined (ARDUINO_ARCH_SAM)
  #include <malloc.h>
  #include <stdlib.h>
  #include <stdio.h>
  #include "DMASAM.h"
#endif

#if defined (ARDUINO_ARCH_SAMD)
  #if defined (ENABLEZERODMA)
    #include "DMASAMD.h"
  #endif
#endif

#if defined (BOARD_RTL8195A)
  #ifdef __cplusplus
    extern "C" {
  #endif

  #include "gpio_api.h"
  #include "PinNames.h"

  #ifdef __cplusplus
    }
  #endif
#endif

#ifndef ARCH_STM32
  #if defined(ARDUINO_ARCH_STM32) || defined(ARDUINO_ARCH_STM32L0) || defined(__STM32F1__) || defined(STM32F1) || defined(STM32F3) || defined(STM32F4) || defined(STM32F0xx)
    #define ARCH_STM32
  #endif
#endif
#if defined (ARDUINO_ARCH_SAM) || defined (ARDUINO_ARCH_SAMD) || defined (ARDUINO_ARCH_ESP8266) || defined (SIMBLEE) || defined (ARDUINO_ARCH_ESP32) || defined (BOARD_RTL8195A) || defined(ARCH_STM32) || defined(ESP32) || defined(NRF52)
// RTL8195A included - @boseji <salearj@hotmail.com> 02.03.17
  #define _delay_us(us) delayMicroseconds(us)
#else
  #include <util/delay.h>
#endif

#define SPIFLASH_LIBVER 3
#define SPIFLASH_LIBSUBVER 4
#define SPIFLASH_REVVER 0

#define SPIFRAM_LIBVER 0
#define SPIFRAM_LIBSUBVER 0
#define SPIFRAM_REVVER 1

class SPIMemory {
public:
  //------------------------------------ Constructor ------------------------------------//
  SPIMemory(void) {};
  ~SPIMemory(void) {};
  //------------------------------- Public functions -----------------------------------//
  //------------------------------- Public variables -----------------------------------//


};

extern SPIMemory SPIMem; //default SPIMemory instance;

#endif // _SPIMEMORY_H_
