wwaltz2/ECE445-UIUC-Heterodyne/(commit log)

2026-02-17 Began PCB design
    [Heterodyne_Board.kicad_pcb, Heterodyne_Board.kicad_sch]
2026-02-17 Added current-limiting R on LED
    [Heterodyne_Board.kicad_sch]
2026-02-17 PreAmp Completed
    Finished schematic of Microphone output preamp and journal entry pre TA meeting
    [Heterodyne_Board.kicad_sch]
2026-02-17 Finished Speaker and Audio Amp Design
    and did journal entry
    [Heterodyne_Board.kicad_sch]
2026-02-19 pushing schematic so evan can see
    lololol
    [Heterodyne_Board.kicad_sch]
2026-02-19 inverted op amp for team captain
    team captain as a role is not confirmed. we may make Evan the court jester
    [Heterodyne_Board.kicad_sch]
2026-02-19 what a greeeeaaat work
    letsa go!
    [Heterodyne_Board.kicad_sch]
2026-02-19 i brokje everything
    got rid of the mixer bc i made an adder instead!!!! HECK!!!! audio module fixed, oscillator still bad :((
    [Heterodyne_Board.kicad_sch]
2026-02-20 fixed osc and mixer
    [Heterodyne_Board.kicad_sch]
2026-02-20 Schematic dun dun DUN
    [Heterodyne_Board.kicad_pcb, Heterodyne_Board.kicad_sch]
2026-02-20 continued PCB design
    modules organized except for audio amp, no wiring yet
    [Heterodyne_Board.kicad_pcb, Heterodyne_Board.kicad_sch]
2026-02-20 finished the basic PCB layout
    no wiring has been done yet though
    [Heterodyne_Board.kicad_pcb, Heterodyne_Board.kicad_sch]
2026-02-20 added two new testpoints
    [Heterodyne_Board.kicad_pcb, Heterodyne_Board.kicad_sch]
2026-02-24 schematic additions
    added audio jack + switches that were forgotten. need to get going on pcb BADLY, no log yet
    [Heterodyne_Board.kicad_sch]
2026-02-25 started routing + fixed schematic
    [Heterodyne_Board.kicad_pcb, Heterodyne_Board.kicad_sch]
2026-02-26 Pushin P
    done with routing!
    [Heterodyne_Board.kicad_pcb, Heterodyne_Board.kicad_sch]
2026-02-26 initial pcb design finished
    missing a couple things but we ship
    [Heterodyne_Board.kicad_pcb, Heterodyne_Board.kicad_sch]
2026-03-02 Fixed MOSI/MISO line, lab entry for 3-1
    [Heterodyne_Board.kicad_sch]
2026-03-03 added switch between mcu and mixer for audio output definition
    [Heterodyne_Board.kicad_pcb, Heterodyne_Board.kicad_sch]
2026-03-03 fixed routing on switch chip
    [Heterodyne_Board.kicad_pcb]
2026-03-03 added subboards under motherboard file, began firmware dev, flipped switch inputs
    [Heterodyne_Board.kicad_sch, Heterodyne_subBoard_Mic.kicad_pcb, Heterodyne_subBoard_Mic.kicad_sch, Heterodyne_subBoard_Speaker_Jack.kicad_pcb, Heterodyne_subBoard_Speaker_Jack.kicad_sch]
2026-03-04 Board round 2 complete, GBRs sent
    Also removed some of the automatic backups cuz they weren't necessary. Made discrete footprint for microphone
    [Heterodyne_Board.kicad_pcb, Heterodyne_Board.kicad_sch, Heterodyne_subBoard_Mic.kicad_pcb, Heterodyne_subBoard_Mic.kicad_sch]
2026-03-04 found arduino firmware for a similar project
2026-03-05 WIP CAD parts
    [Dial.ipt, Top_Shell.ipt]
2026-03-05 Added Program Flowchart
2026-03-09 Updated PCB
    Mounting holes, second ISP header, wider board. Total dimensions about 70x70mm now.
    [Heterodyne_Board.kicad_pcb, Heterodyne_Board.kicad_sch]
2026-03-09 pushing working audioloader
    [Library speed comparisons.xlsx, Winbond Flash Instructions - Comparison.xlsx]
2026-03-12 Round 3 PCB upload
    [Heterodyne_Board-B_Cu.gbr, Heterodyne_Board-B_Mask.gbr, Heterodyne_Board-B_Paste.gbr, Heterodyne_Board-B_Silkscreen.gbr, Heterodyne_Board-Edge_Cuts.gbr, Heterodyne_Board-F_Cu.gbr, Heterodyne_Board-F_Mask.gbr, Heterodyne_Board-F_Paste.gbr]
2026-03-23 updated schematic a lil
    [Heterodyne_Board.kicad_sch]
2026-03-23 Chassis Assembly V1
    [Assembly.iam, Bottom_Shell.ipt, Top_Shell.ipt]
2026-03-23 attempted to fix mixer
    made progress by changing 3v3 references to GND but spice is being weird and not converging...
2026-03-24 updated board with mcu flash fixes
    [Heterodyne_Board.kicad_sch]
2026-03-24 added toggle switches for ease of programming on board
    [Heterodyne_Board.kicad_sch]
2026-03-24 finished mcu flash schematic and audio gate logic
    from now on, mcu audio will play iff the button is held down!!!
    [Heterodyne_Board.kicad_sch]
2026-03-24 FINAL BOARD REV
    [Heterodyne_Board.kicad_pcb, Heterodyne_Board.kicad_sch]
2026-03-25 stared at bill pcb
    it good
    [Heterodyne_Board.kicad_pcb, Heterodyne_Board.kicad_sch]
2026-03-26 submitted board rev 4
    PCB sent off to fab
    [Heterodyne_Board-B_Cu.gbr, Heterodyne_Board-B_Mask.gbr, Heterodyne_Board-B_Paste.gbr, Heterodyne_Board-B_Silkscreen.gbr, Heterodyne_Board-Edge_Cuts.gbr, Heterodyne_Board-F_Cu.gbr, Heterodyne_Board-F_Mask.gbr, Heterodyne_Board-F_Paste.gbr]
2026-03-27 Chassis V2
    [Assembly.iam, Bottom_Shell.ipt, Dial.ipt, Top_Shell.ipt]
2026-04-06 second iteration of firmware and software!
    literally no errors probably
    [AudioLoader_SPIMem.ino, AudioXfer.pde, FourAudioTransfers.pde, TrinketPlayer.ino]
2026-04-09 Chassis V2.5 & Printer Files
    [Assembly.iam, Bottom_Shell.ipt, Bottom_Shell.stl, Bottom_Shell.stp, Dial.ipt, Dial.stl, Dial.stp, Top_Shell.ipt]
2026-04-10 even more firmware fixes
    uint8 substituted for uint32 lol
    [AudioLoader_SPIMem.ino, FourAudioTransfers.pde, TrinketPlayer.ino]
2026-04-14 3d printer 3mf and gcode
    [Bottom_Shell.3mf, Bottom_Shell.stl, Bottom_Shell.stp, team3.3mf]
2026-04-14 3mf gcode
    [team3.gcode.3mf]
2026-04-19 cad work? maybe
    Lemme know kyle can open this
    [Assembly.0020.iam, Assembly.iam, Bottom_Shell.0023.ipt, Bottom_Shell.ipt, Dial.0013.ipt, Dial.ipt, FreqDial.ipt, Top_Shell.0025.ipt]
2026-04-19 put assembly stl in 3d printer files
    [Assembly.stl]
2026-04-19 did more lol
    [Assembly.0020.iam, Assembly.0021.iam, Assembly.3mf, Assembly.gcode.3mf, Assembly.iam, Bottom_Shell.stl, Dial.stl, Top_Shell.stl]
2026-04-19 Finished audio engineering
    [group3BatDetector.gcode.3mf]
2026-04-20 Chassis V3
    [Assembly.0021.iam, Assembly.0025.iam, Assembly.iam, Bottom_Shell.0023.ipt, Bottom_Shell.0028.ipt, Bottom_Shell.ipt, Bottom_Shell.stl, Bottom_Shell.stp]
2026-04-22 Top shell hole modifications
    [Top_Shell.0026.ipt, Top_Shell.0032.ipt, Top_Shell.ipt, Top_Shell.stl, Top_Shell.stp]
2026-04-22 new top shell gcode
    [team3.3mf, team3.gcode.3mf]
2026-04-23 Update evandm2 Engineering Log 4-23-26.md
    couple changes to my log
2026-04-27 last minute bottom shell changes
    [Assembly.0025.iam, Assembly.0026.iam, Assembly.iam, Bottom_Shell.0028.ipt, Bottom_Shell.0030.ipt, Bottom_Shell.ipt, Bottom_Shell.stl, team3.3mf]
