wwaltz2/ECE445-UIUC-Heterodyne/Journals/kaj5/4-16-26-Printed_Chassis_2_5.jpg

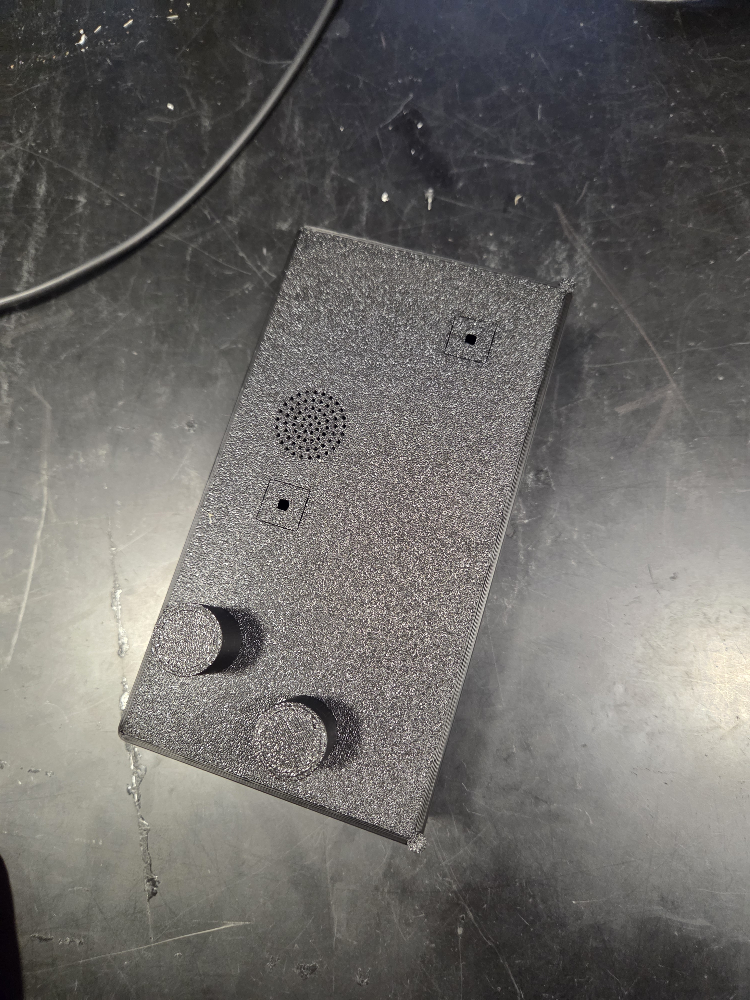
Journals/kaj5/4-16-26-Printed_Chassis_2_5.jpg
